Niranjan2003/bluetooth-controlled-hovercraft/Project documentation/w61.png

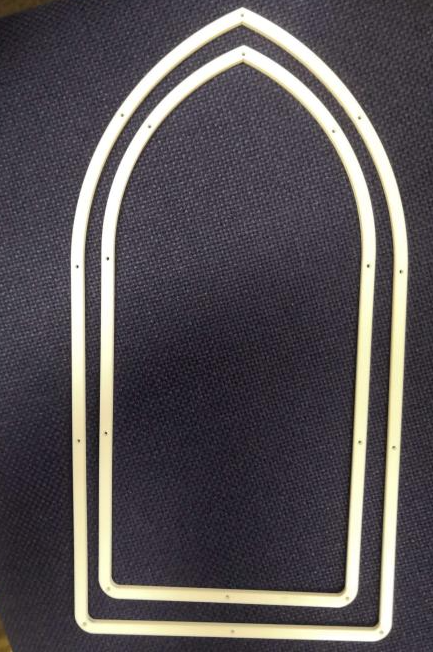
Project documentation/w61.png
