Niranjan2003/bluetooth-controlled-hovercraft/Project documentation/w62.png

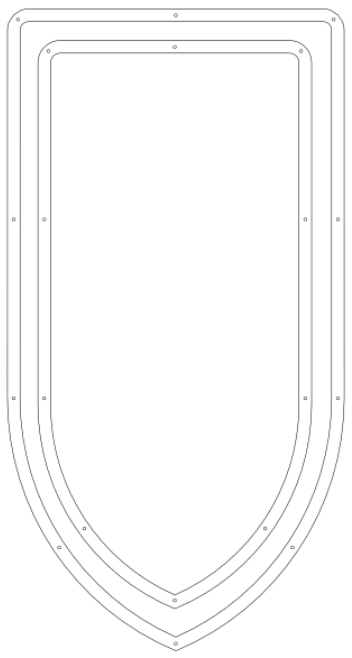
Project documentation/w62.png
