Niranjan2003/bluetooth-controlled-hovercraft/Project documentation/w63.png

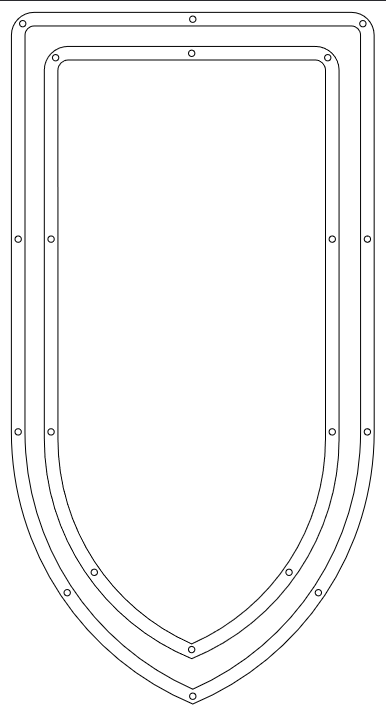
Project documentation/w63.png
